tiacsys/ecad-coffeecaller/images/github-repo.png

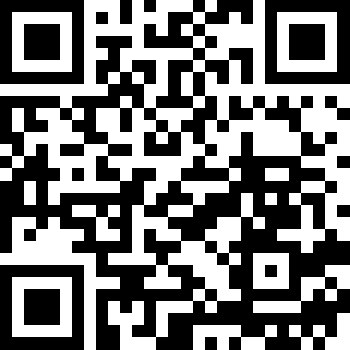
images/github-repo.png
