tiacsys/ecad-coffeecaller/coffeecaller.pdf

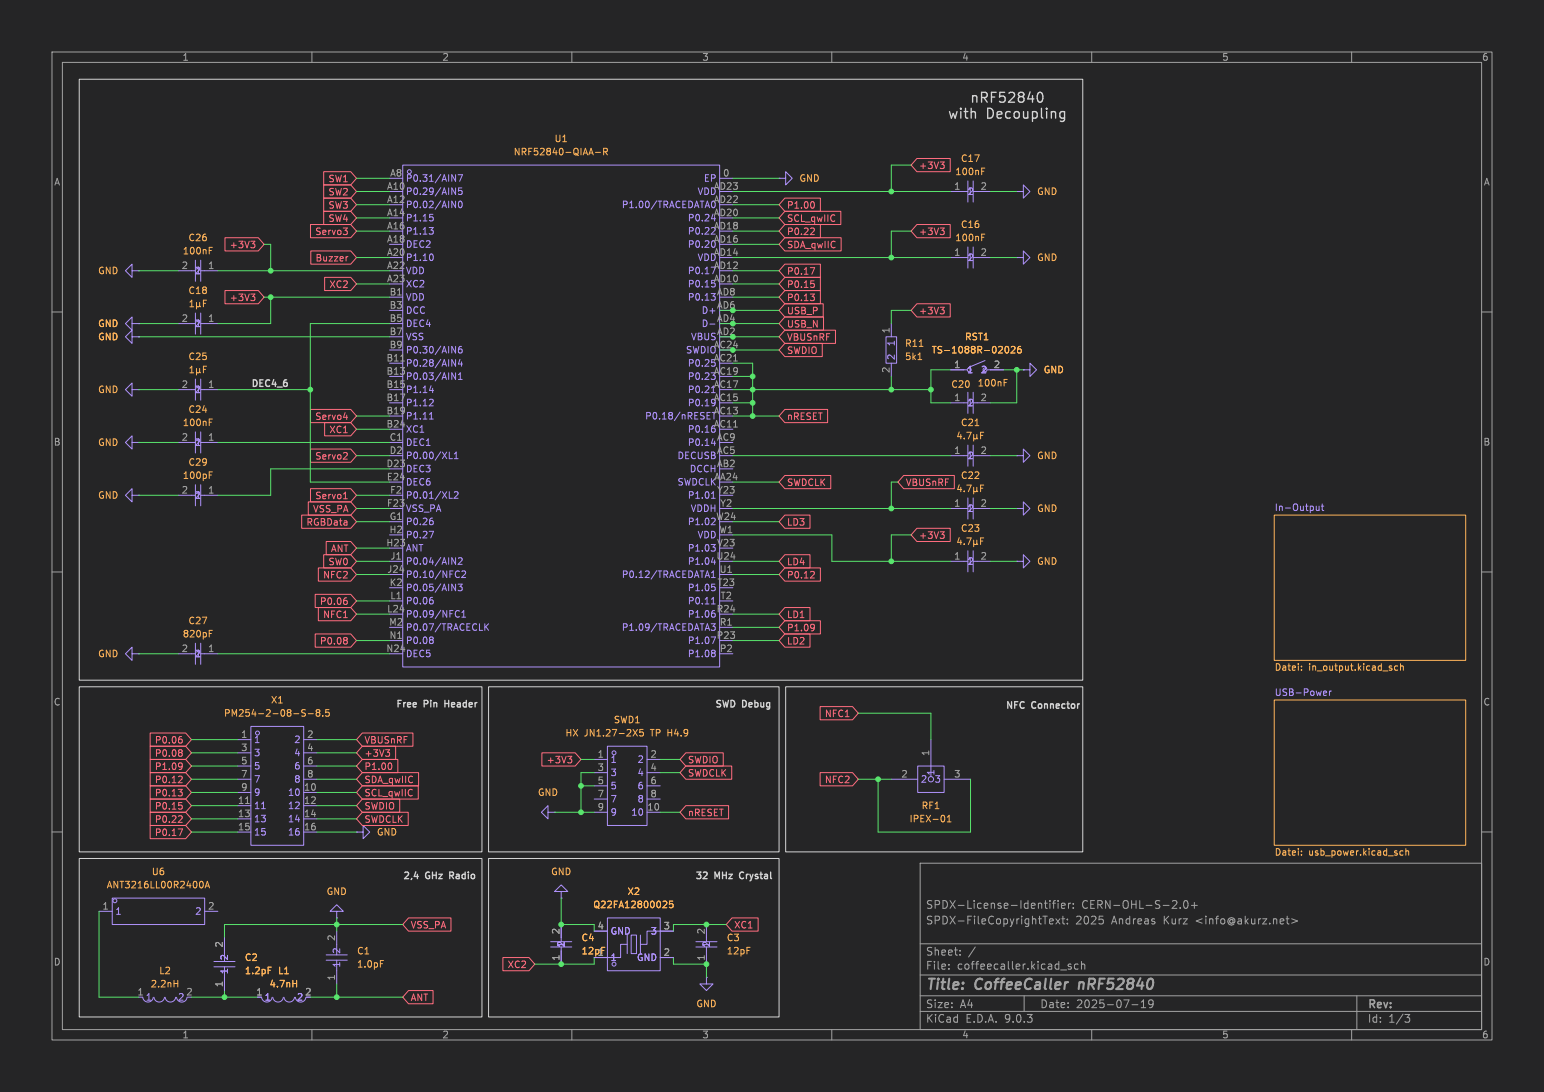
[picture p3: page 1]

NFC Connector 32 MHz Crystal

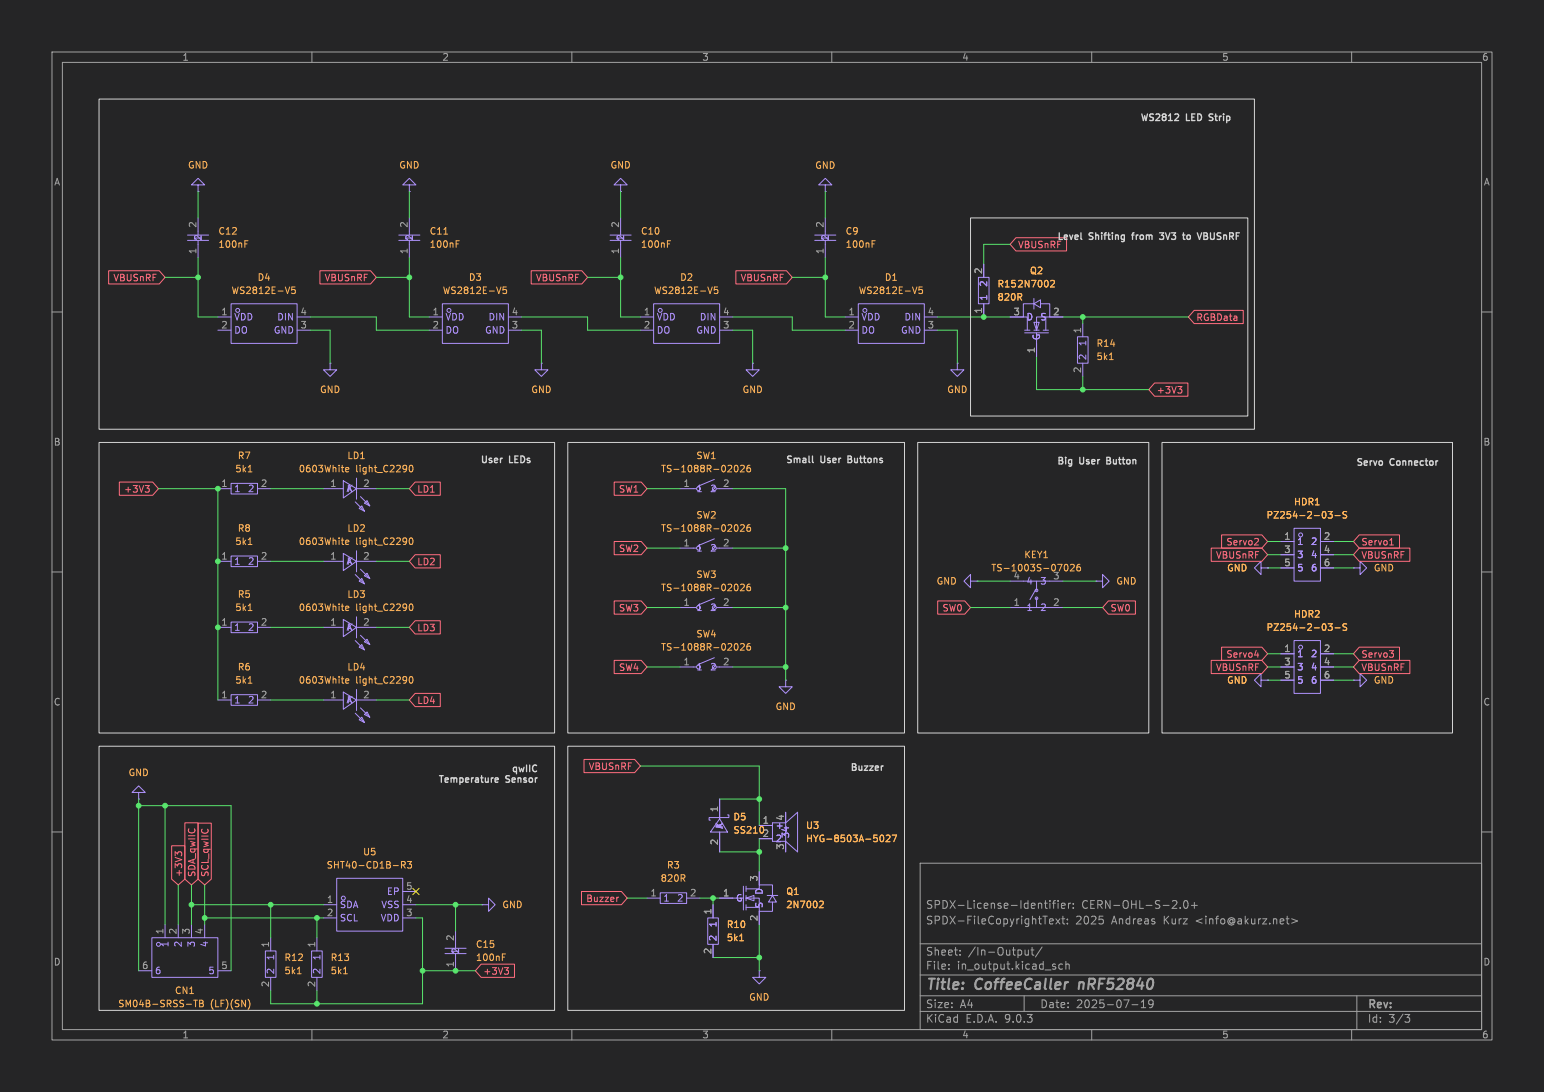
[picture p4: page 2]

VBUSnRF Small User Buttons qwIIC

File: in_output.kicad_sch Sheet: /In-Output/

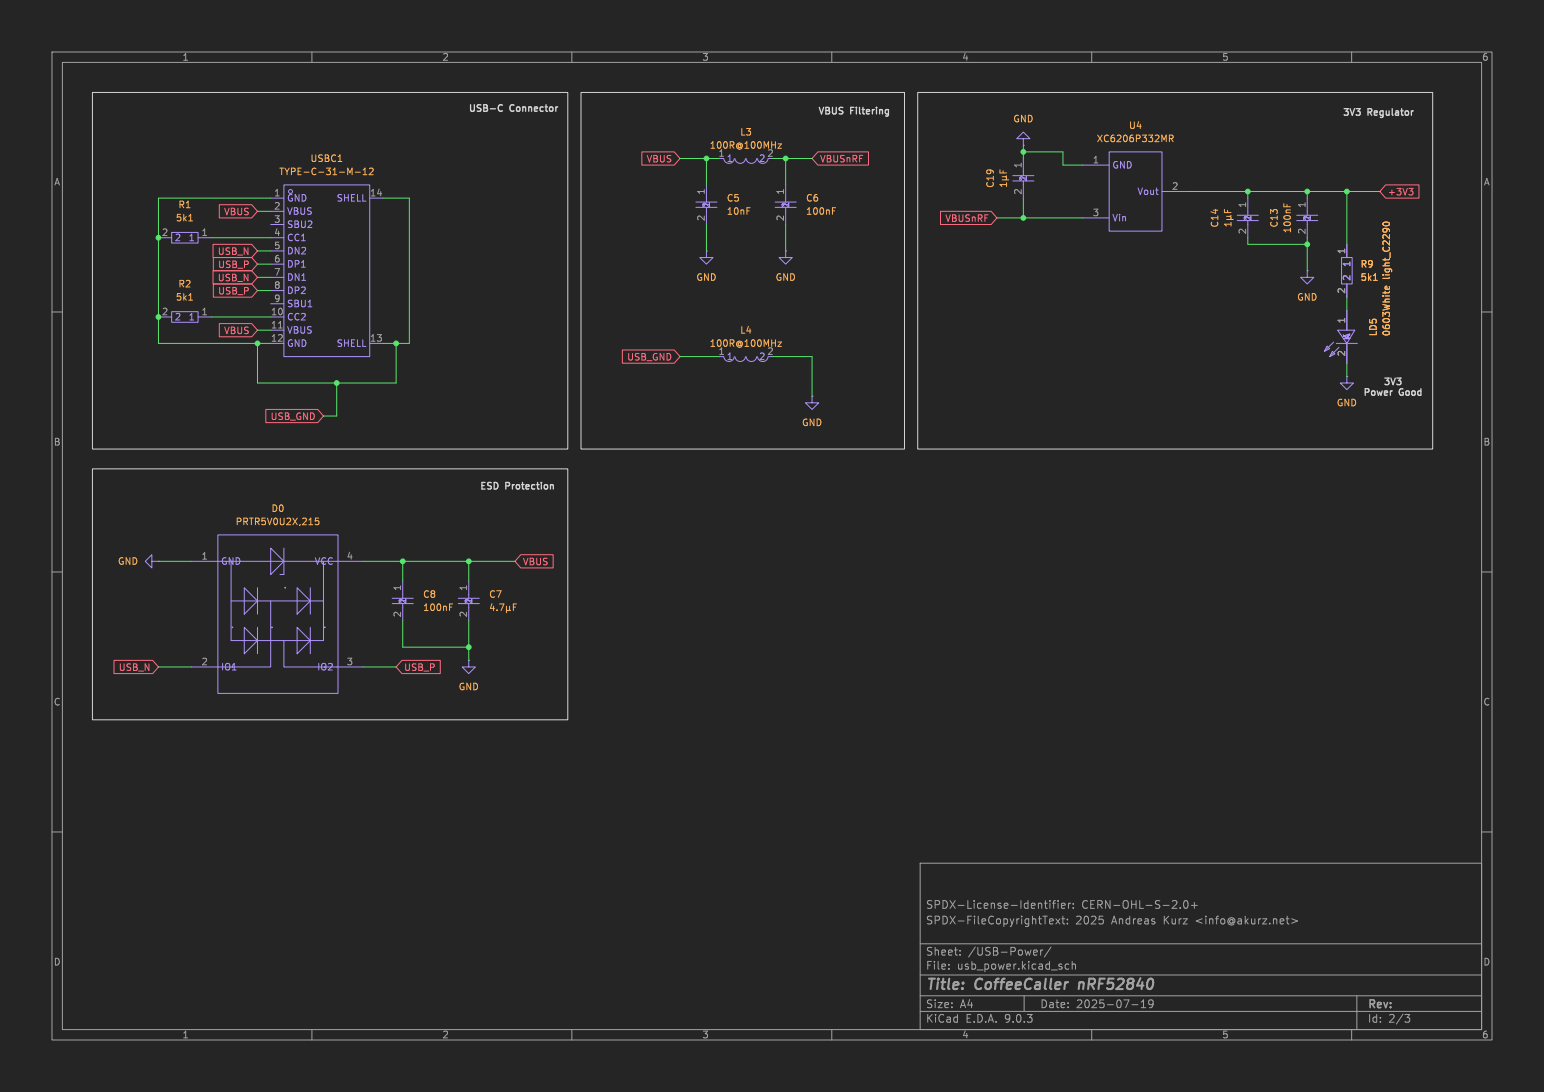
[picture p5: page 3]

2 C14 þÿ1µF GND 1 Vout 2 Vin 3 U4 XC6206P332MR
