tiacsys/ecad-coffeecaller/(commit log)

2025-03-17 feat: initial commit
    [in_output.kicad_sch, nrfCoffee.kicad_pcb, nrfCoffee.kicad_sch, untitled.kicad_sch]
2025-03-17 chore: replace tantal with mlcc
    Some rerouting and Board cleanups.
    [nrfCoffee.kicad_pcb, nrfCoffee.kicad_sch, untitled.kicad_sch]
2025-03-17 chore: replace extended with basic parts
    [in_output.kicad_sch, nrfCoffee.kicad_pcb, nrfCoffee.kicad_sch, untitled.kicad_sch]
2025-04-06 chore: minor fixes to positionings
    [nrfCoffee.kicad_pcb]
2025-04-06 chore: reroute USB and decoupling
    [nrfCoffee.kicad_pcb]
2025-04-29 chore: minor corrections
    [nrfCoffee.kicad_pcb, nrfCoffee.kicad_sch]
2025-04-29 feat: add more buttons
    Existing button and LEDs were renamed to make room for more features to
    come.
    [in_output.kicad_sch, nrfCoffee.kicad_pcb, nrfCoffee.kicad_sch, untitled.kicad_sch]
2025-04-29 feat: add 4 leds and 4 buttons
    [in_output.kicad_sch, nrfCoffee.kicad_pcb, nrfCoffee.kicad_sch]
2025-05-02 chore: use correct resistor values for LD1-4
    Power LED was also added to indicate whether the board is powered and
    3V3 are present.
    [in_output.kicad_sch, nrfCoffee.kicad_pcb, untitled.kicad_sch]
2025-05-02 chore: use different buttons
    Pushing buttons from the side might be difficult due to pcb edges etc.
    [in_output.kicad_sch]
2025-05-02 chore: add 3v3 to LD5 as power label
2025-05-02 chore: make GND pad solid under nRF52
2025-05-03 chore: tidy up schematics
    [in_output.kicad_sch, nrfCoffee.kicad_sch, untitled.kicad_sch]
2025-05-04 chore: rename untitled to usb_power
    [nrfCoffee.kicad_sch, usb_power.kicad_sch]
2025-05-07 feat: replace testpoint with pin header
    This allows soldering a Pin header to the free pins which is much more
    convinient than soldering wires to pads.
    [nrfCoffee.kicad_sch]
2025-05-07 chore: replace ws2812 with recent version
    The original parts are no longer available and therefore exchanged with
    ones in stock.
    [in_output.kicad_sch]
2025-05-07 chore: move qwIIC connector closer to the edge
2025-05-09 fix: replace capacitors with correct values
    [in_output.kicad_sch, nrfCoffee.kicad_sch, usb_power.kicad_sch]
2025-05-09 chore: switch LDO with basic part
    [usb_power.kicad_sch]
2025-05-09 feat: use basic LDO and reroute 3V3
    [usb_power.kicad_sch]
2025-05-13 feat: component updates and rerouting
    [in_output.kicad_sch, nrfCoffee.kicad_sch]
2025-05-18 chore: add netfiltering for GND on USB
    [usb_power.kicad_sch]
2025-05-18 feat: add reset button
    reroute LEDs and change R to 820 with 0603
    [in_output.kicad_sch, nrfCoffee.kicad_sch, usb_power.kicad_sch]
2025-05-18 chore: change ferrite beads to basic components
    [usb_power.kicad_sch]
2025-05-18 fead: add flyback diode for buzzer
    [in_output.kicad_sch]
2025-05-23 chore: use cheaper USB-C connector
    [usb_power.kicad_sch]
2025-05-24 chore: use more available 12x12 switch
    [in_output.kicad_sch]
2025-05-24 feat: add pull-ups for i2c
    [in_output.kicad_sch]
2025-06-24 chore: re-arrange LED in 2x2 matrix
    [nrfCoffee.kicad_sch]
2025-06-28 feat: add level shifter for ws2812
    [in_output.kicad_sch]
2025-06-29 chore: fix typo in schematic
    [nrfCoffee.kicad_sch]
2025-06-29 feat: add connector for 4 servos
    [in_output.kicad_sch, nrfCoffee.kicad_sch]
2025-07-01 feat: add new header for free pins
    [nrfCoffee.kicad_sch]
2025-07-01 feat: add IPEX connector for nfc
    [nrfCoffee.kicad_sch]
2025-07-02 chore: tidy up silkscreen
2025-07-12 chore: minor clean ups
    [in_output.kicad_sch, nrfCoffee.kicad_sch]
2025-07-12 feat: use smd connector for servos
    [in_output.kicad_sch]
2025-07-12 feat: use cheaper and more available antenna
    [nrfCoffee.kicad_sch]
2025-07-12 fix: use correct pinning for LDO
    The LDO was incorrectly in the Database so that Vin and Vout switched
    positions. This leads to incorrect functioning of the LDO - basically as
    a diode dropping the voltage by 0,7 V
    [usb_power.kicad_sch]
2025-07-12 feat: add M2 mounting holes
2025-07-14 chore: use more correct trace width for RF
    For a two layer board the correct trace width for 50 Ohms should be
    around 2,7 mm. This is quite thick and doesn't connect well to the
    existing pads. Therefore it's reduced to 1,7 mm as mentioned in the
    datasheet for the antenna.
    Also a test point is added to connect analyzers directly to the RF
    output.
2025-07-15 chore: increase LED resistor to 5k1
    The power and normal GPIO driven LEDs are quite bright. So the resistor
    is increased to 5k1 as this type is already in use on the board.
    [in_output.kicad_sch, usb_power.kicad_sch]
2025-07-15 chore: rename to coffeecaller
    [coffeecaller.kicad_sch, in_output.kicad_sch, nrfCoffee.kicad_sch, usb_power.kicad_sch]
2025-07-15 chore: redraw levelshifting circuit
    No changes in PCB
    [in_output.kicad_sch]
2025-07-16 feat: add license to repo
    [coffeecaller.kicad_sch, in_output.kicad_sch, usb_power.kicad_sch]
2025-07-19 fix: level in levelshifter too low on high frequencies
    The pull-up resistor to 5V was too big causing the levels not raising
    high enough to provide a good signal for the WS2812 RGB LEDs. This is
    fixed by choosing a smaller resistor and removing the current limiter
    from the microcontroller to the source of the levelshifter's MOSFET.
    [coffeecaller.kicad_sch, in_output.kicad_sch, usb_power.kicad_sch]
